PUT-Motorsport/PUTM_EV_FRONT_BOX_2022/Front Box płytka pozioma/Front Box płytka pozioma.kicad_pcb

## KiCad design Front Box płytka pozioma/Front Box płytka pozioma.kicad_pcb (2022-06-23)

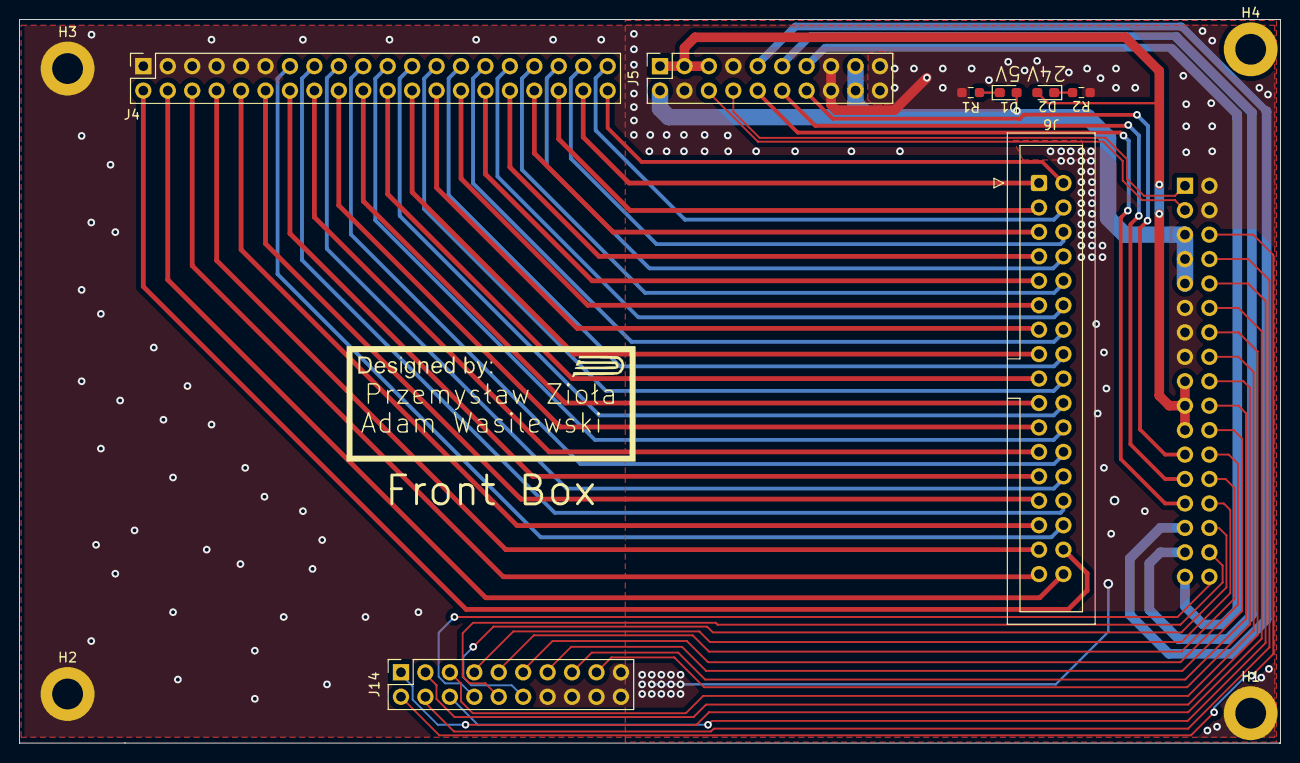
[picture p7: board Front Box płytka pozioma.kicad_pcb from above]

Board: 4 copper layers, 131.1 x 75.2 mm, 13 parts (1 on the bottom side), 62 nets.

Parts:
D1: 5v indicator; LED_0603_1608Metric_Pad1.05x0.95mm_HandSolder
D2: 24v indicator; LED_0603_1608Metric_Pad1.05x0.95mm_HandSolder
H1, H2, H3, H4: MountingHole_Pad; MountingHole_3.2mm_M3_DIN965_Pad
J4: Sygnały; PinSocket_2x20_P2.54mm_Vertical
J5: Zasilanie+CAN; PinSocket_2x10_P2.54mm_Vertical
J6: Taśma IDC dolna; IDC-Header_2x17_P2.54mm_Vertical
J14: Diagnostyka; PinSocket_2x10_P2.54mm_Vertical
J15: sockety płytka pozioma; PinSocket_2x17_P2.54mm_Vertical
R1, R2: 480R; R_0603_1608Metric_Pad0.98x0.95mm_HandSolder

Connections:
+5V: D1.2 (A), J5.2, J5.17, J5.18, J15.5, J15.7, J15.9
/+24F2: D2.2 (A), J5.1, J5.3, J5.5, J15.17, J15.19, J15.21
/BRAKE_PRESSURE1: J4.12, J6.27
/BRAKE_PRESSURE2: J4.14, J6.25
/BSPD-CURRENT: J4.6, J6.33
/CAN+: J5.6, J15.3
/CAN-: J5.8, J15.1
/CLK1: J14.10, J15.32
/CLK2: J14.9, J15.26
/CLK3: J14.15, J15.20
/CLK4: J14.4, J15.8
/CLK5: J14.3, J15.14
/INERTIA: J4.32, J6.7
/KILL_KIERA: J4.26, J6.13
/KILL_LEWY: J4.30, J6.9
/KILL_PRAWY: J4.28, J6.11
/K_ANALOG0: J4.29, J6.14
/K_OUTPUT0: J4.31, J6.12
/K_OUTPUT1: J4.33, J6.10
/K_OUTPUT2: J4.35, J6.8
/OVERTRAVEL: J4.34, J6.5
/PITOT1: J4.2, J6.32
/PITOT2: J4.4, J6.34
/POT_ZAWIAS2: J4.18, J6.21
/POT_ZAWIAS_1: J4.16, J6.23
/RST1: J14.12, J15.30
/RST2: J14.11, J15.24
/RST3: J14.17, J15.18
/RST4: J14.6, J15.10
/RST5: J14.5, J15.16
/S15: J4.15, J6.28
/S17: J4.17, J6.26
/S19: J4.19, J6.24
/S21: J4.21, J6.22
/S23: J4.23, J6.20
/S25: J4.25, J6.18
/S27: J4.27, J6.16
/S36: J4.36, J6.3
/SAFE-IN: J4.8, J6.31
/SAFE-OUT: J4.10, J6.29
/SIG_APPS1: J4.38, J6.1
/SIG_APPS2: J4.40, J6.2
/SWD1: J14.8, J15.34
/SWD2: J14.7, J15.28
/SWD3: J14.13, J15.22
/SWD4: J14.2, J15.6
/SWD5: J14.1, J15.12
/TEMP1: J4.24, J6.15
/TIM_IN0: J4.37, J6.6
/TIM_IN1: J4.39, J6.4
/WHEELSPEED1: J4.20, J6.19
/WHEELSPEED2: J4.22, J6.17
/WOLNY: J4.13, J6.30
/Z9: J5.9, J15.29
/Z10: J5.10, J15.27
/Z11: J5.11, J15.31
/Z12: J5.12, J15.25
/Z13: J5.13, J15.33
/Z14: J5.14, J15.23
GND: H1.1, H2.1, H3.1, J4.1, J4.3, J4.5, J4.7, J4.9, J4.11, J5.4, J5.7, J5.15, J5.16, J5.19, J5.20, J14.14, J14.16, J14.18, J14.19, J14.20, J15.2, J15.4, J15.11, J15.13, J15.15, R1.1, R2.2
unnamed: D1.1 (K), R1.2
unnamed: D2.1 (K), R2.1
