PUT-Motorsport/PUTM_EV_FRONT_BOX_2022/Front Box płytka diagnostyczna/Front Box płytka diagnostyczna.kicad_pcb

## KiCad design Front Box płytka diagnostyczna/Front Box płytka diagnostyczna.kicad_pcb (2022-06-14)

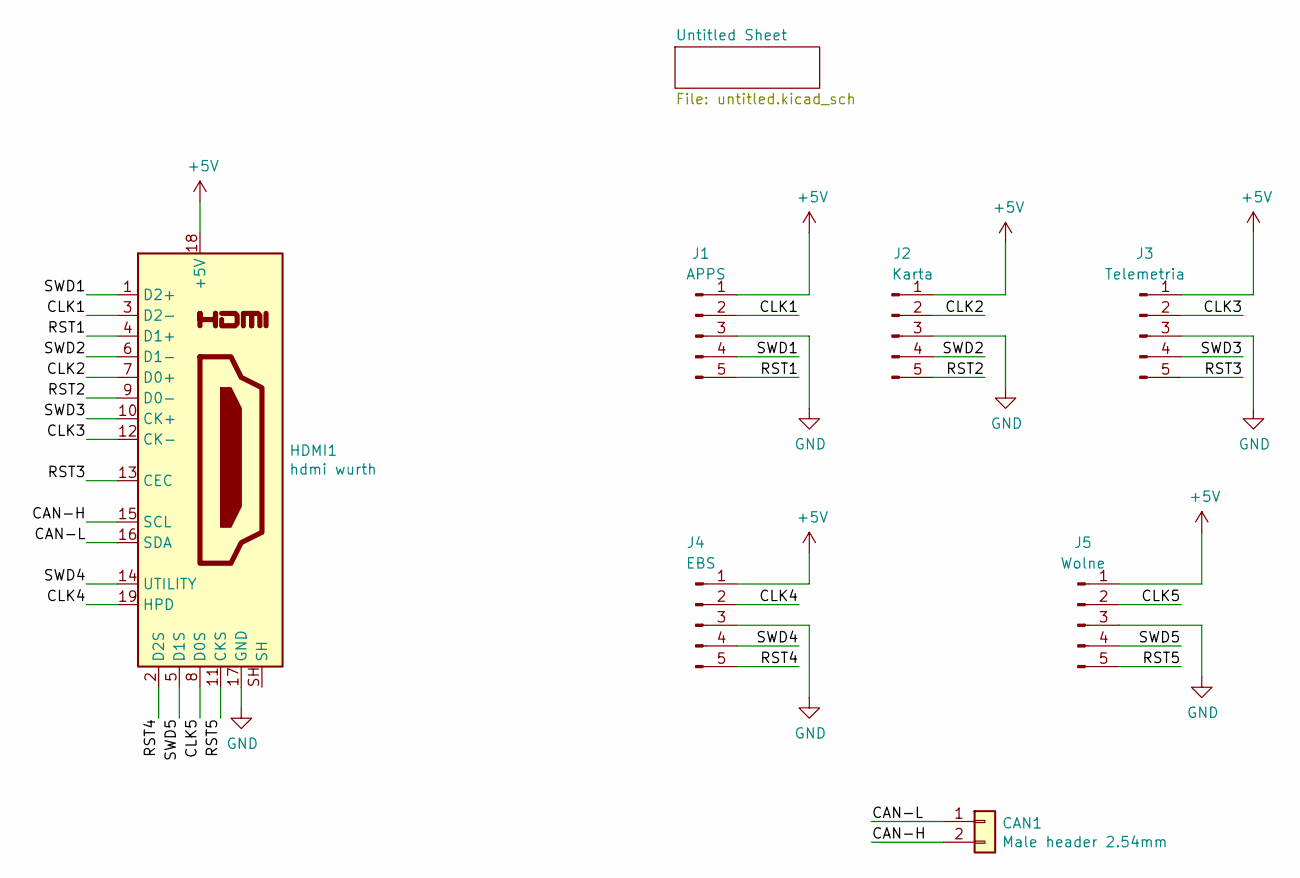
[picture p8: schematic Front Box płytka diagnostyczna.kicad_sch]

Parts:
CAN1: Male header 2.54mm; PinHeader_1x02_P2.54mm_Vertical
HDMI1: hdmi wurth; 685119134923
J1: APPS; PinHeader_1x05_P2.54mm_Vertical
J2: Karta; PinHeader_1x05_P2.54mm_Vertical
J3: Telemetria; PinHeader_1x05_P2.54mm_Vertical
J4: EBS; PinHeader_1x05_P2.54mm_Vertical
J5: Wolne; PinHeader_1x05_P2.54mm_Vertical

Connections:
+5V: HDMI1.18 (+5V), J1.1, J2.1, J3.1, J4.1, J5.1
/CAN-H: CAN1.2, HDMI1.15 (SCL)
/CAN-L: CAN1.1, HDMI1.16 (SDA)
/CLK1: HDMI1.3 (D2-), J1.2
/CLK2: HDMI1.7 (D0+), J2.2
/CLK3: HDMI1.12 (CK-), J3.2
/CLK4: HDMI1.19 (HPD), J4.2
/CLK5: HDMI1.8 (D0S), J5.2
/RST1: HDMI1.4 (D1+), J1.5
/RST2: HDMI1.9 (D0-), J2.5
/RST3: HDMI1.13 (CEC), J3.5
/RST4: HDMI1.2 (D2S), J4.5
/RST5: HDMI1.11 (CKS), J5.5
/SWD1: HDMI1.1 (D2+), J1.4
/SWD2: HDMI1.6 (D1-), J2.4
/SWD3: HDMI1.10 (CK+), J3.4
/SWD4: HDMI1.14 (UTILITY), J4.4
/SWD5: HDMI1.5 (D1S), J5.4
GND: HDMI1.17 (GND), J1.3, J2.3, J3.3, J4.3, J5.3

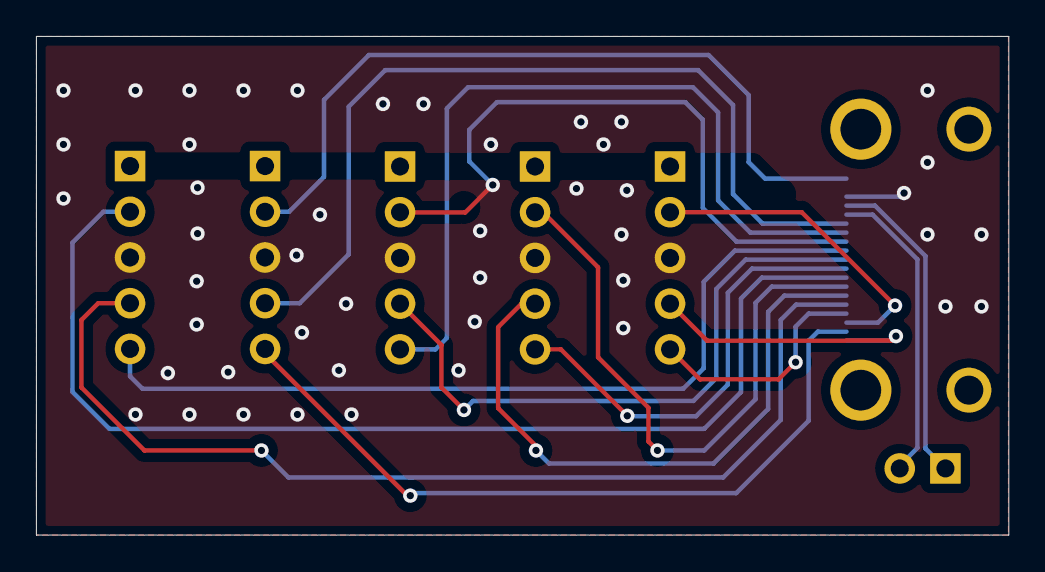
[picture p9: board Front Box płytka diagnostyczna.kicad_pcb from above]

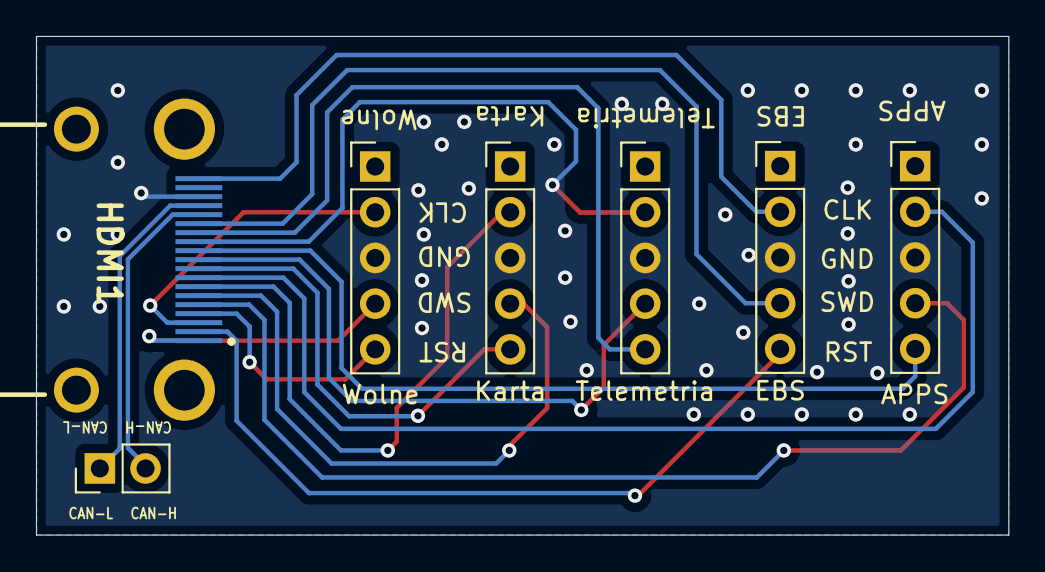
[picture p10: board Front Box płytka diagnostyczna.kicad_pcb from below]

Board: 2 copper layers, 54.0 x 27.7 mm, 7 parts (7 on the bottom side), 19 nets.
