PUT-Motorsport/PUTM_EV_FRONT_BOX_2022/Front Box płytka pionowa/Front Box płytka pionowa.kicad_pcb

## KiCad design Front Box płytka pionowa/Front Box płytka pionowa.kicad_pcb (2022-04-08)

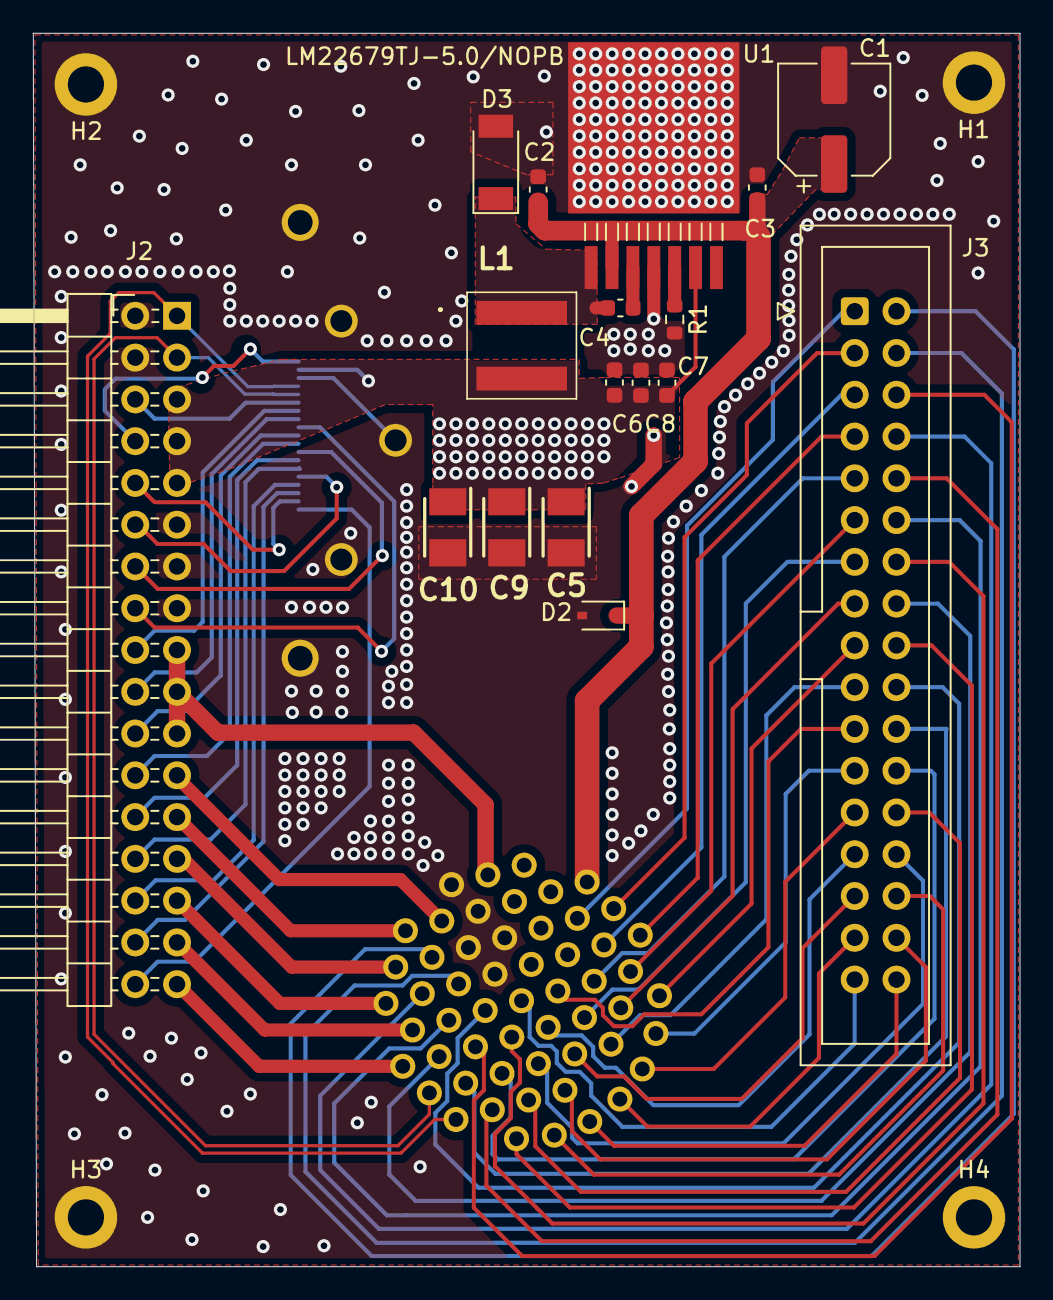
[picture p11: board Front Box płytka pionowa.kicad_pcb from above]

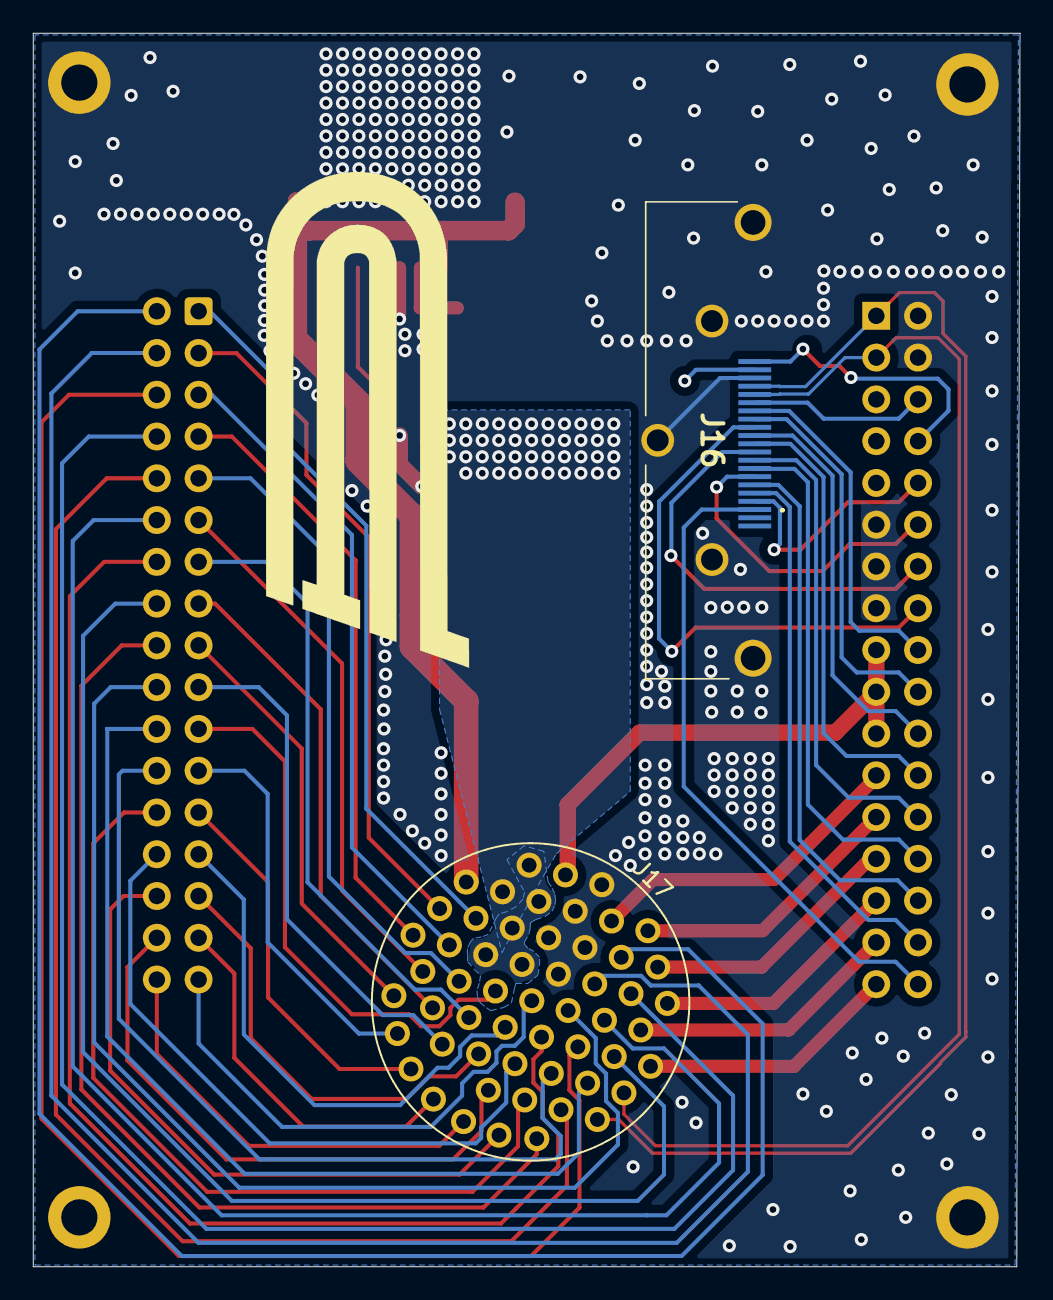
[picture p12: board Front Box płytka pionowa.kicad_pcb from below]

Board: 4 copper layers, 60.0 x 75.0 mm, 23 parts (2 on the bottom side), 64 nets.

Parts:
C1: 22uF; CP_Elec_6.3x5.8
C2: 4.7uF; C_0603_1608Metric
C3: 1uF; C_0603_1608Metric
C4: 10nF; C_0603_1608Metric
C5, C9, C10: 68uF; CAPPM3528X210N
C6, C7, C8: 100nF; C_0603_1608Metric
D2: SD36_SOD323; D_SOD-323
D3: Schottky 60V 5A; D_SOD-128
H1, H2, H3, H4: MountingHole_Pad; MountingHole_2.2mm_M2_DIN965_Pad
J2: piny kątowe; PinHeader_2x17_P2.54mm_Horizontal
J3: Taśma IDC góra; IDC-Header_2x17_P2.54mm_Vertical
J16: hdmi diagnostyka; SS53000003
J17: Złącze TE; TE-AUTOSPORT-16-36
L1: 6.8uH; 74439346068
R1: 9k; R_0603_1608Metric
U1: LM22679TJ-5.0/NOPB; LM22679TJ-5.0&slash_NOPB

Connections:
+5V: C5.1, C6.1, C7.1, C8.1, C9.1, C10.1, J2.5, J2.7, J2.9, J16.18 (+5V), J17.8, J17.9, J17.13, J17.14, J17.15, J17.21, L1.2, U1.6 (FB)
/+24F1: C1.1, C2.1, C3.1, D2.1 (A1), J17.3, U1.2 (VIN)
/płytka pionowa/+24F2: J2.17, J2.19, J2.21, J17.16
/płytka pionowa/BRAKE_PRESSURE1: J3.27, J17.27
/płytka pionowa/BRAKE_PRESSURE2: J3.25, J17.17
/płytka pionowa/BSPD-CURRENT: J3.33, J17.28
/płytka pionowa/CAN+: J2.3, J16.15 (SCL), J17.54
/płytka pionowa/CAN-: J2.1, J16.16 (SDA), J17.53
/płytka pionowa/CLK1: J2.32, J16.3 (D2-)
/płytka pionowa/CLK2: J2.26, J16.7 (D0+)
/płytka pionowa/CLK3: J2.20, J16.12 (CK-)
/płytka pionowa/CLK4: J2.8, J16.19 (HPD)
/płytka pionowa/CLK5: J2.14, J16.8 (D0S)
/płytka pionowa/INERTIA: J3.7, J17.1
/płytka pionowa/KILL_KIERA: J3.13, J17.19
/płytka pionowa/KILL_LEWY: J3.9, J17.12
/płytka pionowa/KILL_PRAWY: J3.11, J17.5
/płytka pionowa/K_ANALOG0: J3.14, J17.35
/płytka pionowa/K_OUTPUT0: J3.12, J17.44
/płytka pionowa/K_OUTPUT1: J3.10, J17.48
/płytka pionowa/K_OUTPUT2: J3.8, J17.45
/płytka pionowa/OVERTRAVEL: J3.5, J17.6
/płytka pionowa/PITOT1: J3.32, J17.33
/płytka pionowa/PITOT2: J3.34, J17.32
/płytka pionowa/POT_ZAWIAS2: J3.21, J17.20
/płytka pionowa/POT_ZAWIAS_1: J3.23, J17.10
/płytka pionowa/RST1: J2.30, J16.4 (D1+)
/płytka pionowa/RST2: J2.24, J16.9 (D0-)
/płytka pionowa/RST3: J2.18, J16.13 (CEC)
/płytka pionowa/RST4: J2.10, J16.2 (D2S)
/płytka pionowa/RST5: J2.16, J16.11 (CKS)
/płytka pionowa/S15: J3.28, J17.34
/płytka pionowa/S17: J3.26, J17.41
/płytka pionowa/S19: J3.24, J17.42
/płytka pionowa/S21: J3.22, J17.49
/płytka pionowa/S23: J3.20, J17.36
/płytka pionowa/S25: J3.18, J17.47
/płytka pionowa/S27: J3.16, J17.50
/płytka pionowa/S36: J3.3, J17.2
/płytka pionowa/SAFE-IN: J3.31, J17.25
/płytka pionowa/SAFE-OUT: J3.29, J17.26
/płytka pionowa/SIG_APPS1: J3.1, J17.7
/płytka pionowa/SIG_APPS2: J3.2, J17.38
/płytka pionowa/SWD1: J2.34, J16.1 (D2+)
/płytka pionowa/SWD2: J2.28, J16.6 (D1-)
/płytka pionowa/SWD3: J2.22, J16.10 (CK+)
/płytka pionowa/SWD4: J2.6, J16.14 (UTILITY)
/płytka pionowa/SWD5: J2.12, J16.5 (D1S)
/płytka pionowa/TEMP1: J3.15, J17.11
/płytka pionowa/TIM_IN0: J3.6, J17.43
/płytka pionowa/TIM_IN1: J3.4, J17.37
/płytka pionowa/WHEELSPEED1: J3.19, J17.18
/płytka pionowa/WHEELSPEED2: J3.17, J17.4
/płytka pionowa/WOLNY: J3.30, J17.40
/płytka pionowa/Z9: J2.29, J17.52
/płytka pionowa/Z10: J2.27, J17.46
/płytka pionowa/Z11: J2.31, J17.51
/płytka pionowa/Z12: J2.25, J17.39
/płytka pionowa/Z13: J2.33, J17.55
/płytka pionowa/Z14: J2.23, J17.31
GND: C1.2, C2.2, C3.2, C5.2, C6.2, C7.2, C8.2, C9.2, C10.2, D2.2 (A2), D3.2 (A), H1.1, H2.1, H3.1, J2.2, J2.4, J2.11, J2.13, J2.15, J16.17 (GND), J16.SH, J17.22, J17.23, J17.24, J17.29, J17.30, R1.2, U1.4 (GND), U1.8 (DAP)
unnamed: C4.1, D3.1 (K), L1.1, U1.1 (SW)
unnamed: C4.2, U1.3 (BOOT)
unnamed: R1.1, U1.5 (IADJ)
