PUT-Motorsport/PUTM_EV_FRONT_BOX_2022/(commit log)

2022-01-23 preproduction review small bug fixes
    [PUTM_EV_Front_Box_2022.kicad_pcb, PUTM_EV_Front_Box_2022.kicad_sch, goldpin-hdmi.kicad_sch, plytka_pionowa.kicad_sch]
2022-01-23 Minor changes
    [PUTM_EV_Front_Box_2022.kicad_pcb, plytka_pionowa.kicad_sch]
2022-01-24 Final changes
    [PUTM_EV_Front_Box_2022_Płytka_Pozioma.kicad_pcb]
2022-01-24 New plains in diagnostyka
    [PUTM_EV_Front_Box_2022-B_Cu.gbl, PUTM_EV_Front_Box_2022-B_Mask.gbs, PUTM_EV_Front_Box_2022-B_Paste.gbp, PUTM_EV_Front_Box_2022-B_Silkscreen.gbo, PUTM_EV_Front_Box_2022-Edge_Cuts.gm1, PUTM_EV_Front_Box_2022-F_Cu.gtl, PUTM_EV_Front_Box_2022-F_Mask.gts, PUTM_EV_Front_Box_2022-F_Paste.gtp]
2022-01-24 New Plains
    [PUTM_EV_Front_Box_2022.csv, PUTM_EV_Front_Box_2022.kicad_pcb, PUTM_EV_Front_Box_2022.kicad_sch, PUTM_EV_Front_Box_2022.sch, file61A2ED8E.sch, goldpin-hdmi.kicad_sch, goldpin-hdmi.sch, plytka_pionowa.kicad_sch]
2022-02-10 Added article
    [PUTM_EV_Front_Box_2022.kicad_pcb, PUTM_EV_Front_Box_2022_Płytka_Pionowa.kicad_pcb]
2022-04-06 Separated boards into individual projects
    [Front Box płytka diagnostyczna.kicad_pcb, Front Box płytka diagnostyczna.kicad_sch, Front Box płytka pionowa.kicad_pcb, Front Box płytka pionowa.kicad_sch, Front Box płytka pozioma.kicad_pcb, Front Box płytka pozioma.kicad_sch, PUTM_EV_Front_Box_2022.csv, PUTM_EV_Front_Box_2022.kicad_pcb]
2022-04-06 New silkscreen and connectors for diagnostic board
    [Front Box płytka diagnostyczna.kicad_sch]
2022-04-08 PCB prepared for gerber generation
    [Front Box płytka diagnostyczna.kicad_pcb, Front Box płytka diagnostyczna.kicad_sch]
2022-04-08 Added missing traces
    [Front Box płytka pionowa.kicad_pcb]
2022-04-08 Even better silkscreen for diagnostic PCB
    [Front Box płytka diagnostyczna.kicad_pcb]
2022-06-14 quick revision
    Added LED's to horizontal board, distance between sockets fix, Diagnostic Board 5v line delete and compatibility with HDMI fix
    [Front Box płytka diagnostyczna.kicad_pcb, Front Box płytka diagnostyczna.kicad_sch, Front Box płytka pozioma.kicad_pcb, Front Box płytka pozioma.kicad_sch, untitled.kicad_sch]
2022-06-23 Changed mounting holes to M3 size because Maciej was crying a lot
    [Front Box płytka pozioma.kicad_pcb, Front Box płytka pozioma.kicad_sch]
