PUT-Motorsport/PUTM_EV_FRONT_BOX_2022/(notices)

Notices in the files:
parts and their libraries:
Copyright 2021 Accelerated Designs. All rights reserved.
